EffectiveRange/pcb-mrhat/effectiveRangeHat_simple.kicad_pcb

## KiCad design effectiveRangeHat_simple.kicad_pcb (2024-08-14)

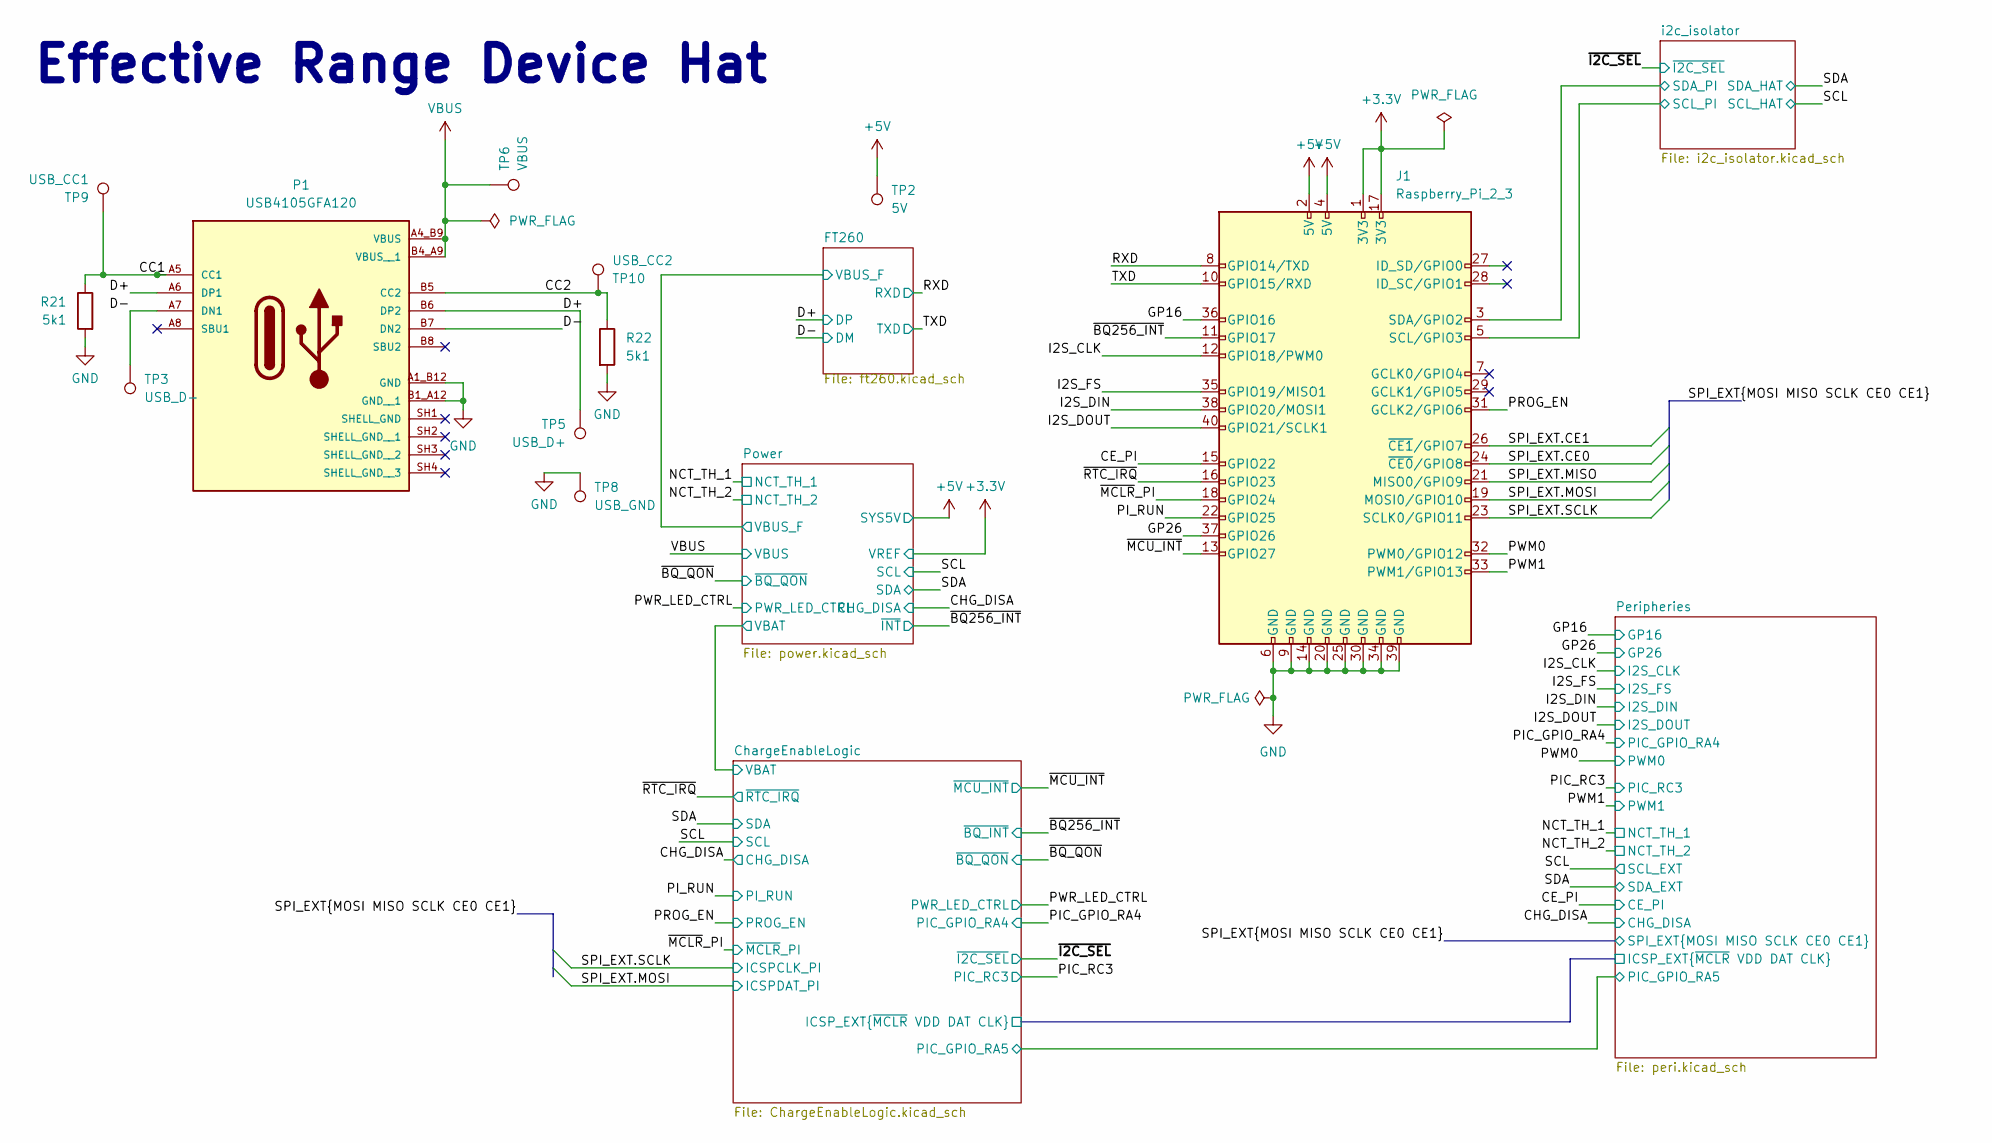
[picture p1: schematic effectiveRangeHat_simple.kicad_sch, Effective Range - MrHAT]

Parts:
J1: Raspberry_Pi_2_3; Raspberry_Pi_Zero_MountingHoles; MPN 61304021121
P1: USB4105GFA120; GCT_USB4105GFA120; PARTREV B3
R21, R22: 5k1; R_0402_1005Metric; MPN ERA-2AEB512X
TP2: 5V; TestPoint_Pad_D1.0mm
TP3: USB_D-; TestPoint_Pad_D1.0mm
TP5: USB_D+; TestPoint_Pad_D1.0mm
TP6: VBUS; TestPoint_Pad_D1.0mm
TP8: USB_GND; TestPoint_Pad_D1.0mm
TP9: USB_CC1; TestPoint_Pad_D1.0mm
TP10: USB_CC2; TestPoint_Pad_D1.0mm

Connections:
+3.3V: J1.1 (3V3), J1.17 (3V3); also elsewhere on the board
+5V: J1.2 (5V), J1.4 (5V), TP2.1; also elsewhere on the board
/CC1: P1.A5 (CC1), R21.1, TP9.1
/CC2: P1.B5 (CC2), R22.1, TP10.1
/CE_PI: J1.15 (GPIO22); also elsewhere on the board
/D+: P1.A6 (DP1), P1.B6 (DP2), TP5.1; also elsewhere on the board
/D-: P1.A7 (DN1), P1.B7 (DN2), TP3.1; also elsewhere on the board
/GP16: J1.36 (GPIO16); also elsewhere on the board
/GP26: J1.37 (GPIO26); also elsewhere on the board
/I2S_CLK: J1.12 (GPIO18/PWM0); also elsewhere on the board
/I2S_DIN: J1.38 (GPIO20/MOSI1); also elsewhere on the board
/I2S_DOUT: J1.40 (GPIO21/SCLK1); also elsewhere on the board
/I2S_FS: J1.35 (GPIO19/MISO1); also elsewhere on the board
/PI_RUN: J1.22 (GPIO25); also elsewhere on the board
/PROG_EN: J1.31 (GCLK2/GPIO6); also elsewhere on the board
/PWM0: J1.32 (PWM0/GPIO12); also elsewhere on the board
/PWM1: J1.33 (PWM1/GPIO13); also elsewhere on the board
/RXD: J1.8 (GPIO14/TXD); also elsewhere on the board
/SPI_EXT.CE0: J1.24 (~CE0/GPIO8); also elsewhere on the board
/SPI_EXT.CE1: J1.26 (~CE1/GPIO7); also elsewhere on the board
/SPI_EXT.MISO: J1.21 (MISO0/GPIO9); also elsewhere on the board
/SPI_EXT.MOSI: J1.19 (MOSI0/GPIO10); also elsewhere on the board
/SPI_EXT.SCLK: J1.23 (SCLK0/GPIO11); also elsewhere on the board
/TXD: J1.10 (GPIO15/RXD); also elsewhere on the board
/i2c_isolator/SCL_PI: J1.5 (SCL/GPIO3); also elsewhere on the board
/i2c_isolator/SDA_PI: J1.3 (SDA/GPIO2); also elsewhere on the board
/~BQ256_INT: J1.11 (GPIO17); also elsewhere on the board
/~MCLR_PI: J1.18 (GPIO24); also elsewhere on the board
/~MCU_INT: J1.13 (GPIO27); also elsewhere on the board
/~RTC_IRQ: J1.16 (GPIO23); also elsewhere on the board
GND: J1.6 (GND), J1.9 (GND), J1.14 (GND), J1.20 (GND), J1.25 (GND), J1.30 (GND), J1.34 (GND), J1.39 (GND), P1.A1_B12 (GND), P1.B1_A12 (GND__1), R21.2, R22.2, TP8.1; also elsewhere on the board
VBUS: P1.A4_B9 (VBUS), P1.B4_A9 (VBUS__1), TP6.1; also elsewhere on the board

Notes on the sheet:
Effective Range Device Hat

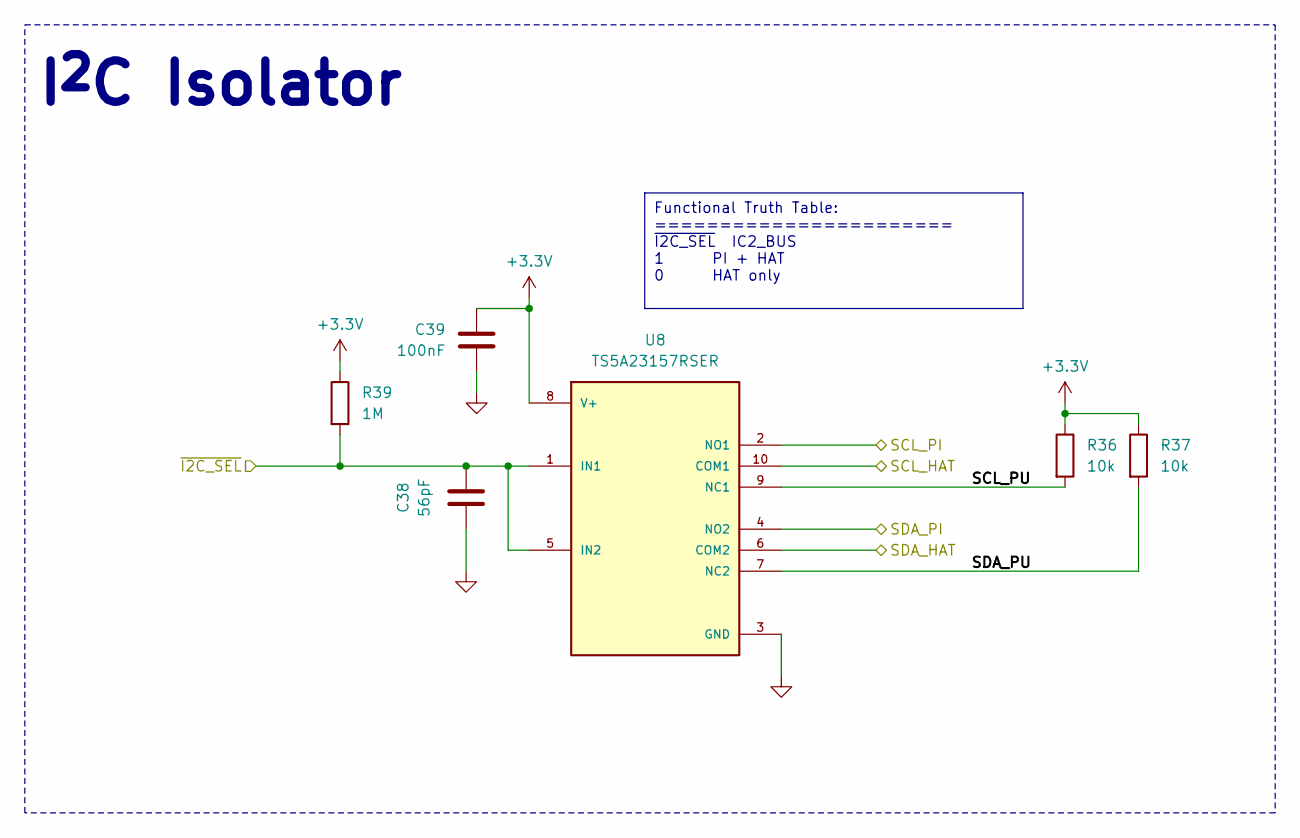
[picture p2: schematic i2c_isolator.kicad_sch, Effective Range - MrHAT]

Parts:
C38: 56pF; C_0402_1005Metric; MPN GRT1555C1H560JA02J
C39: 100nF; C_0402_1005Metric; MPN GRM155R71E104KE14J
R36, R37: 10k; R_0402_1005Metric; MPN ERJ-2GEJ103X
R39: 1M; R_0402_1005Metric; MPN ERJ-2RKF1004X
U8: TS5A23157RSER; IC_TS5A23157RSER; PARTREV 4220307/A 03/2020

Connections:
+3.3V: C39.2, R36.1, R37.1, R39.1, U8.8 (V+); also elsewhere on the board
/SCL: U8.10 (COM1); also elsewhere on the board
/SDA: U8.6 (COM2); also elsewhere on the board
/i2c_isolator/SCL_PI: U8.2 (NO1); also elsewhere on the board
/i2c_isolator/SCL_PU: R36.2, U8.9 (NC1)
/i2c_isolator/SDA_PI: U8.4 (NO2); also elsewhere on the board
/i2c_isolator/SDA_PU: R37.2, U8.7 (NC2)
/~I2C_SEL: C38.1, R39.2, U8.1 (IN1), U8.5 (IN2); also elsewhere on the board
GND: C38.2, C39.1, U8.3 (GND); also elsewhere on the board

Notes on the sheet:
Functional Truth Table: ======================= ~{I2C_SEL} IC2_BUS 1 PI + HAT 0 HAT only
I^{2}C Isolator

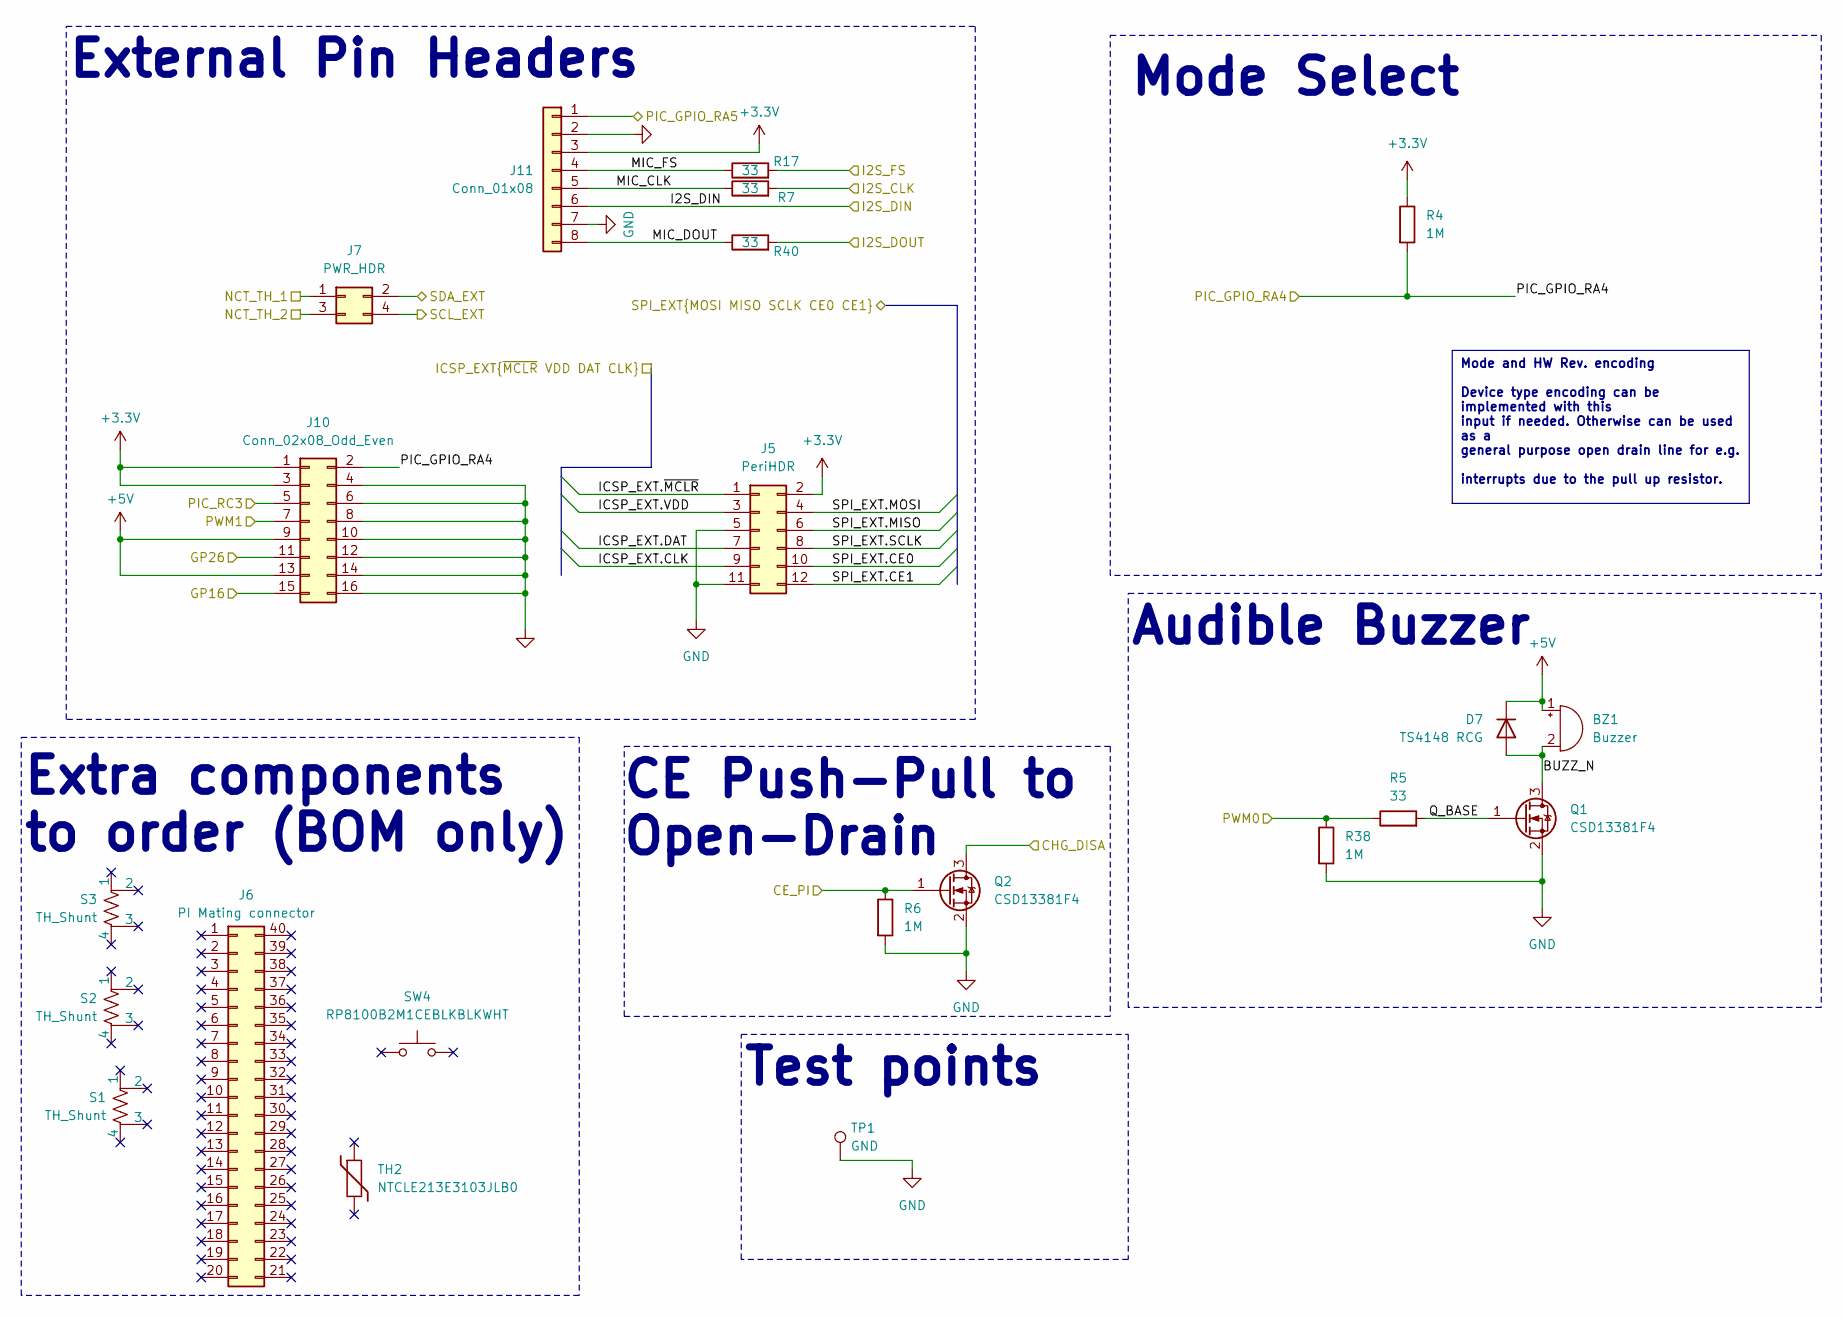
[picture p3: schematic peri.kicad_sch, Effective Range - MrHAT]

Parts:
BZ1: Buzzer; MagneticBuzzer_CUI_CMT-8504-100-SMT; MPN CMT-8504-100-SMT-TR
D7: TS4148 RCG; D_0603_1608Metric; MPN TS4148 RCG
J5: PeriHDR; PinHeader_2x06_P2.54mm_Vertical; MPN 61301221121
J6: PI Mating connector; MPN PPPC202LFBN-RC
J7: PWR_HDR; PinHeader_2x02_P2.54mm_Vertical; MPN 61300421121
J10: Conn_02x08_Odd_Even; PinHeader_2x08_P2.54mm_Vertical; MPN 61301621121
J11: Conn_01x08; PinHeader_1x08_P2.54mm_Vertical; MPN 61300811121
Q1, Q2: CSD13381F4; YJC0003A_TEX; MPN CSD13381F4
R4: 1M; R_0402_1005Metric; MPN ERJ-2RKF1004X
R5, R7, R17, R40: 33; R_0402_1005Metric; MPN ERJ-2RKF33R0X
R6, R38: 1M; R_0402_1005Metric; Tolerance 1%; MPN ERJ-2RKF1004X
S1, S2, S3: TH_Shunt; MPN QPC02SXGN-RC
SW4: RP8100B2M1CEBLKBLKWHT; MPN RP8100B2M1CEBLKBLKWHT
TH2: NTCLE213E3103JLB0; MPN NXFT15XH103FEAB035
TP1: GND; TestPoint_Pad_D1.0mm

Connections:
+3.3V: J5.2, J10.1, J10.3, J11.3, R4.1; also elsewhere on the board
+5V: BZ1.1 (+), D7.1 (K), J10.9, J10.13; also elsewhere on the board
/CE_PI: Q2.1 (G), R6.1; also elsewhere on the board
/CHG_DISA: Q2.3 (D); also elsewhere on the board
/ChargeEnableLogic/ICSP_EXT.CLK: J5.9; also elsewhere on the board
/ChargeEnableLogic/ICSP_EXT.DAT: J5.7; also elsewhere on the board
/ChargeEnableLogic/ICSP_EXT.VDD: J5.3; also elsewhere on the board
/ChargeEnableLogic/ICSP_EXT.~MCLR: J5.1; also elsewhere on the board
/ChargeEnableLogic/PIC_GPIO_RA5: J11.1; also elsewhere on the board
/GP16: J10.15; also elsewhere on the board
/GP26: J10.11; also elsewhere on the board
/I2S_CLK: R7.2; also elsewhere on the board
/I2S_DIN: J11.6; also elsewhere on the board
/I2S_DOUT: R40.2; also elsewhere on the board
/I2S_FS: R17.2; also elsewhere on the board
/NCT_TH_1: J7.1; also elsewhere on the board
/NCT_TH_2: J7.3; also elsewhere on the board
/PIC_GPIO_RA4: J10.2, R4.2; also elsewhere on the board
/PIC_RC3: J10.5; also elsewhere on the board
/PWM0: R5.1, R38.1; also elsewhere on the board
/PWM1: J10.7; also elsewhere on the board
/Peripheries/BUZZ_N: BZ1.2 (-), D7.2 (A), Q1.3 (D)
/Peripheries/MIC_CLK: J11.5, R7.1
/Peripheries/MIC_DOUT: J11.8, R40.1
/Peripheries/MIC_FS: J11.4, R17.1
/Peripheries/Q_BASE: Q1.1 (G), R5.2
/SCL: J7.4; also elsewhere on the board
/SDA: J7.2; also elsewhere on the board
/SPI_EXT.CE0: J5.10; also elsewhere on the board
/SPI_EXT.CE1: J5.12; also elsewhere on the board
/SPI_EXT.MISO: J5.6; also elsewhere on the board
/SPI_EXT.MOSI: J5.4; also elsewhere on the board
/SPI_EXT.SCLK: J5.8; also elsewhere on the board
GND: J5.5, J5.11, J10.4, J10.6, J10.8, J10.10, J10.12, J10.14, J10.16, J11.2, J11.7, Q1.2 (S), Q2.2 (S), R6.2, R38.2, TP1.1; also elsewhere on the board

Notes on the sheet:
Mode and HW Rev. encoding Device type encoding can be implemented with this input if needed. Otherwise can be used as a general purpose open drain line for e.g. interrupts due to the pull up resistor.
Mode Select
CE Push-Pull to Open-Drain
Audible Buzzer
Test points
Extra components to order (BOM only)
External Pin Headers

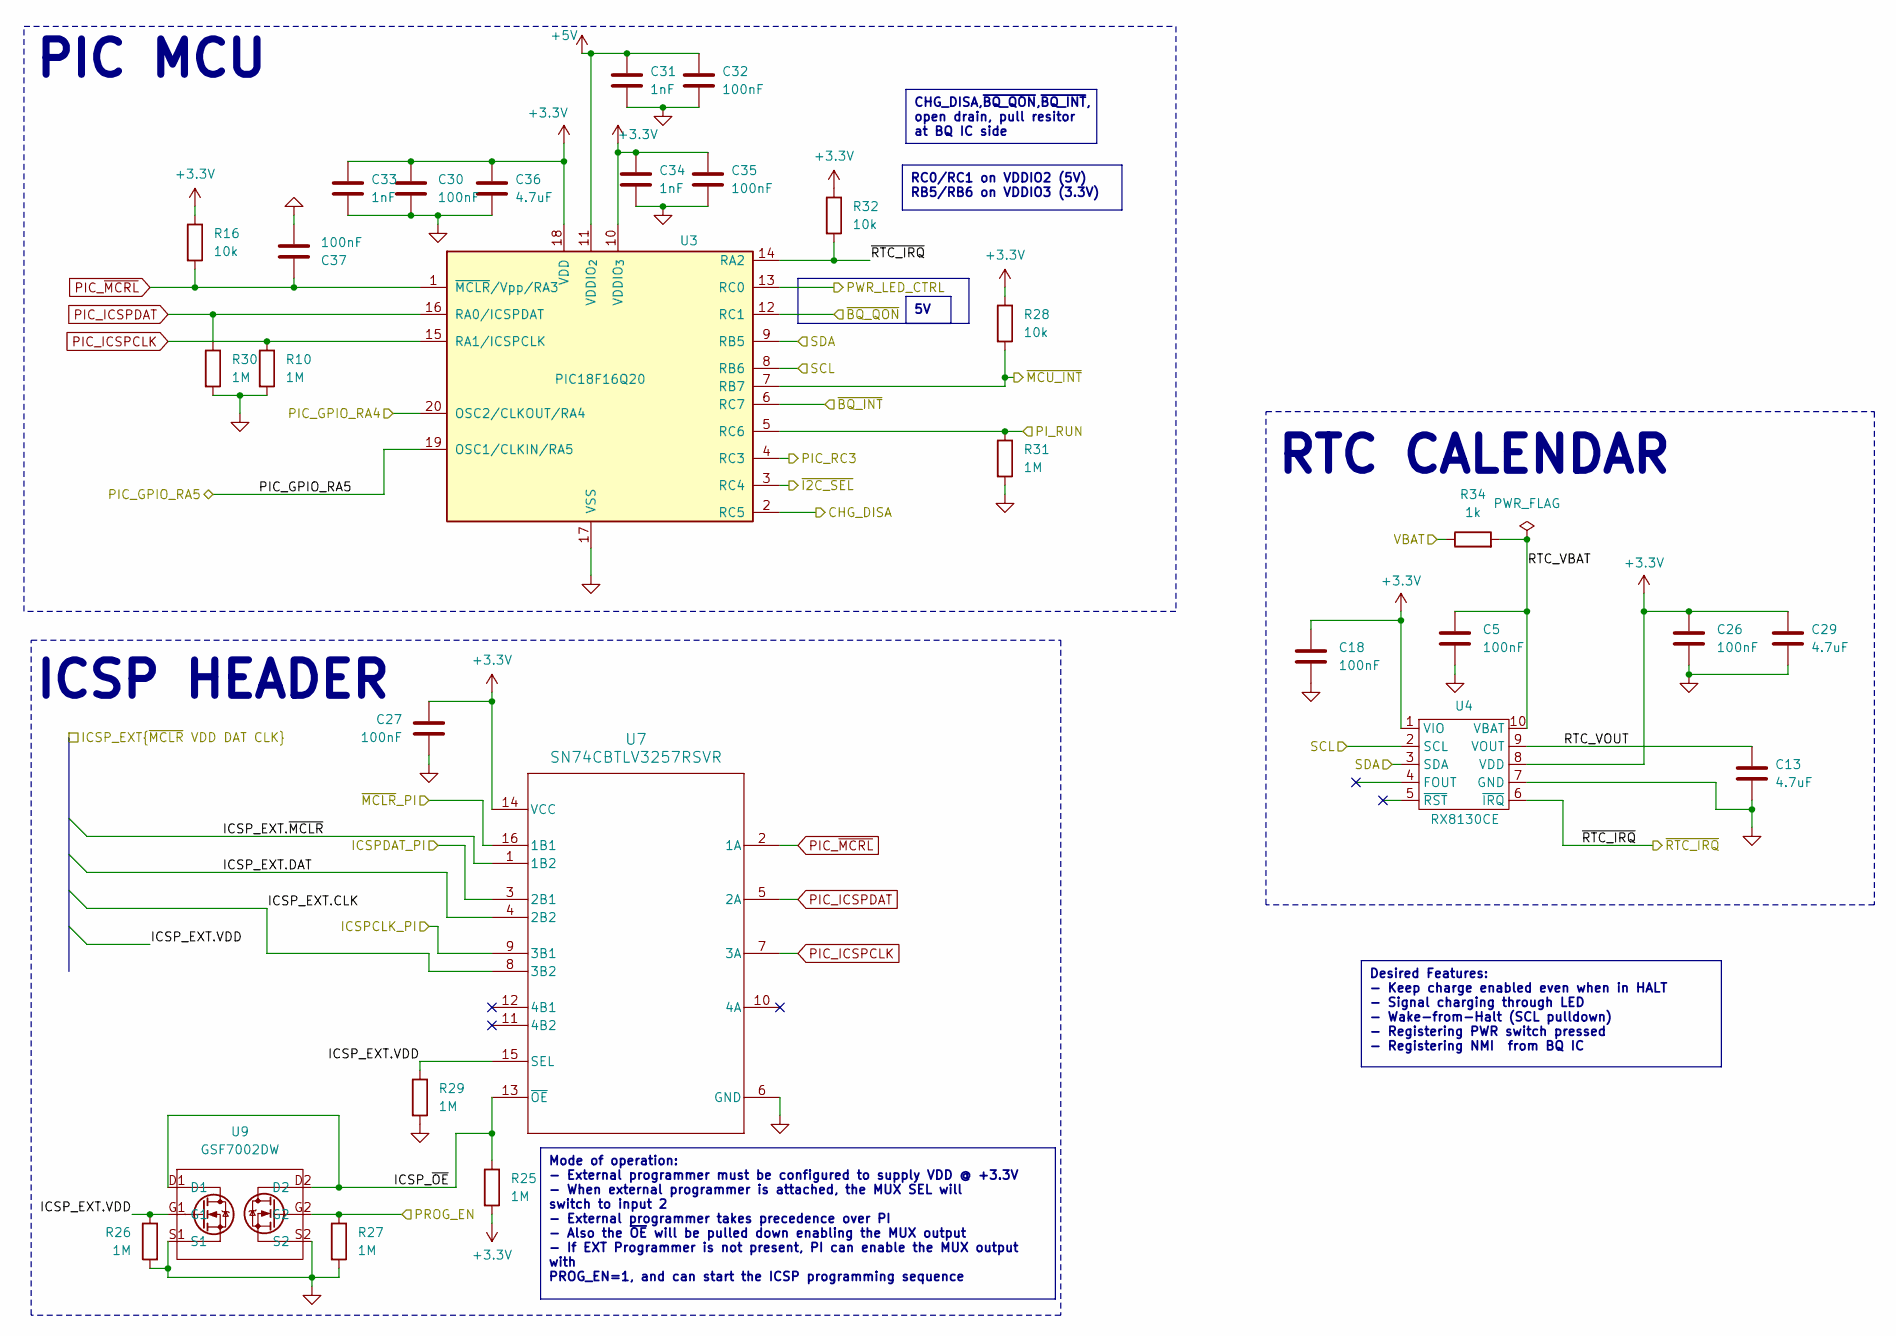
[picture p4: schematic ChargeEnableLogic.kicad_sch, Effective Range - MrHAT]

Parts:
C5, C18, C26, C27, C30, C32, C35, C37: 100nF; C_0402_1005Metric; MPN GRM155R71E104KE14J
C13, C29, C36: 4.7uF; C_0805_2012Metric; MPN GRM21BR61H475KE51L
C31, C33, C34: 1nF; C_0402_1005Metric; MPN GCM155R72A102KA37D
R10, R25, R29, R30, R31: 1M; R_0402_1005Metric; MPN ERJ-2RKF1004X
R16, R28, R32: 10k; R_0402_1005Metric; MPN ERJ-2GEJ103X
R26, R27: 1M; R_0402_1005Metric; Tolerance 1%; MPN ERJ-2RKF1004X
R34: 1k; R_0402_1005Metric; MPN ERJ-2RKF1001X
U3: PIC18F16Q20; VQFN-20-1EP_3x3mm_P0.4mm_EP1.7x1.7mm; MPN PIC18F16Q20-I/REB
U4: RX8130CE; MPN RX8130CE B0
U7: SN74CBTLV3257RSVR; RSV0016A; MPN SN74CBTLV3257RSVR
U9: GSF7002DW; MPN GSF7002DW

Connections:
+3.3V: C18.1, C26.1, C27.2, C29.1, C30.2, C33.1, C34.1, C35.1, C36.1, R16.1, R25.2, R28.1, R32.1, U3.10 (VDDIO_{3}), U3.18 (VDD), U4.1 (VIO), U4.8 (VDD), U7.14 (VCC); also elsewhere on the board
+5V: C31.1, C32.1, U3.11 (VDDIO_{2}); also elsewhere on the board
/CHG_DISA: U3.2 (RC5); also elsewhere on the board
/ChargeEnableLogic/ICSP_EXT.CLK: U7.8 (3B2); also elsewhere on the board
/ChargeEnableLogic/ICSP_EXT.DAT: U7.4 (2B2); also elsewhere on the board
/ChargeEnableLogic/ICSP_EXT.VDD: R26.1, R29.1, U7.15 (SEL), U9.G1; also elsewhere on the board
/ChargeEnableLogic/ICSP_EXT.~MCLR: U7.1 (1B2); also elsewhere on the board
/ChargeEnableLogic/ICSP_~OE: R25.1, U7.13 (~OE), U9.D1, U9.D2
/ChargeEnableLogic/PIC_GPIO_RA5: U3.19 (OSC1/CLKIN/RA5); also elsewhere on the board
/ChargeEnableLogic/RTC_VBAT: C5.1, R34.2, U4.10 (VBAT)
/ChargeEnableLogic/RTC_VOUT: C13.1, U4.9 (VOUT)
/PIC_GPIO_RA4: U3.20 (OSC2/CLKOUT/RA4); also elsewhere on the board
/PIC_RC3: U3.4 (RC3); also elsewhere on the board
/PI_RUN: R31.1, U3.5 (RC6); also elsewhere on the board
/PROG_EN: R27.1, U9.G2; also elsewhere on the board
/PWR_LED_CTRL: U3.13 (RC0); also elsewhere on the board
/Power/BAT: R34.1; also elsewhere on the board
/SCL: U3.8 (RB6), U4.2 (SCL); also elsewhere on the board
/SDA: U3.9 (RB5), U4.3 (SDA); also elsewhere on the board
/SPI_EXT.MOSI: U7.3 (2B1); also elsewhere on the board
/SPI_EXT.SCLK: U7.9 (3B1); also elsewhere on the board
/~BQ256_INT: U3.6 (RC7); also elsewhere on the board
/~BQ_QON: U3.12 (RC1); also elsewhere on the board
/~I2C_SEL: U3.3 (RC4); also elsewhere on the board
/~MCLR_PI: U7.16 (1B1); also elsewhere on the board
/~MCU_INT: R28.2, U3.7 (RB7); also elsewhere on the board
/~RTC_IRQ: R32.2, U3.14 (RA2), U4.6 (~IRQ); also elsewhere on the board
GND: C5.2, C13.2, C18.2, C26.2, C27.1, C29.2, C30.1, C31.2, C32.2, C33.2, C34.2, C35.2, C36.2, C37.1, R10.2, R26.2, R27.2, R29.2, R30.2, R31.2, U3.17 (VSS), U3.21 (VSS), U4.7 (GND), U7.6 (GND), U9.S1, U9.S2; also elsewhere on the board
PIC_ICSPCLK: R10.1, U3.15 (RA1/ICSPCLK), U7.7 (3A)
PIC_ICSPDAT: R30.1, U3.16 (RA0/ICSPDAT), U7.5 (2A)
PIC_~MCRL: C37.2, R16.2, U3.1 (~MCLR/Vpp/RA3), U7.2 (1A)

Notes on the sheet:
RC0/RC1 on VDDIO2 (5V) RB5/RB6 on VDDIO3 (3.3V)
Desired Features: - Keep charge enabled even when in HALT - Signal charging through LED - Wake-from-Halt (SCL pulldown) - Registering PWR switch pressed - Registering NMI from BQ IC
CHG_DISA,~{BQ_QON},~{BQ_INT}, open drain, pull resitor at BQ IC side
Mode of operation: - External programmer must be configured to supply VDD @ +3.3V - When external programmer is attached, the MUX SEL will switch to input 2 - External programmer takes precedence over PI - Also the ~{OE} will be pulled down enabling the MUX output - If EXT Programmer is not present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
RTC CALENDAR
ICSP HEADER
PIC MCU

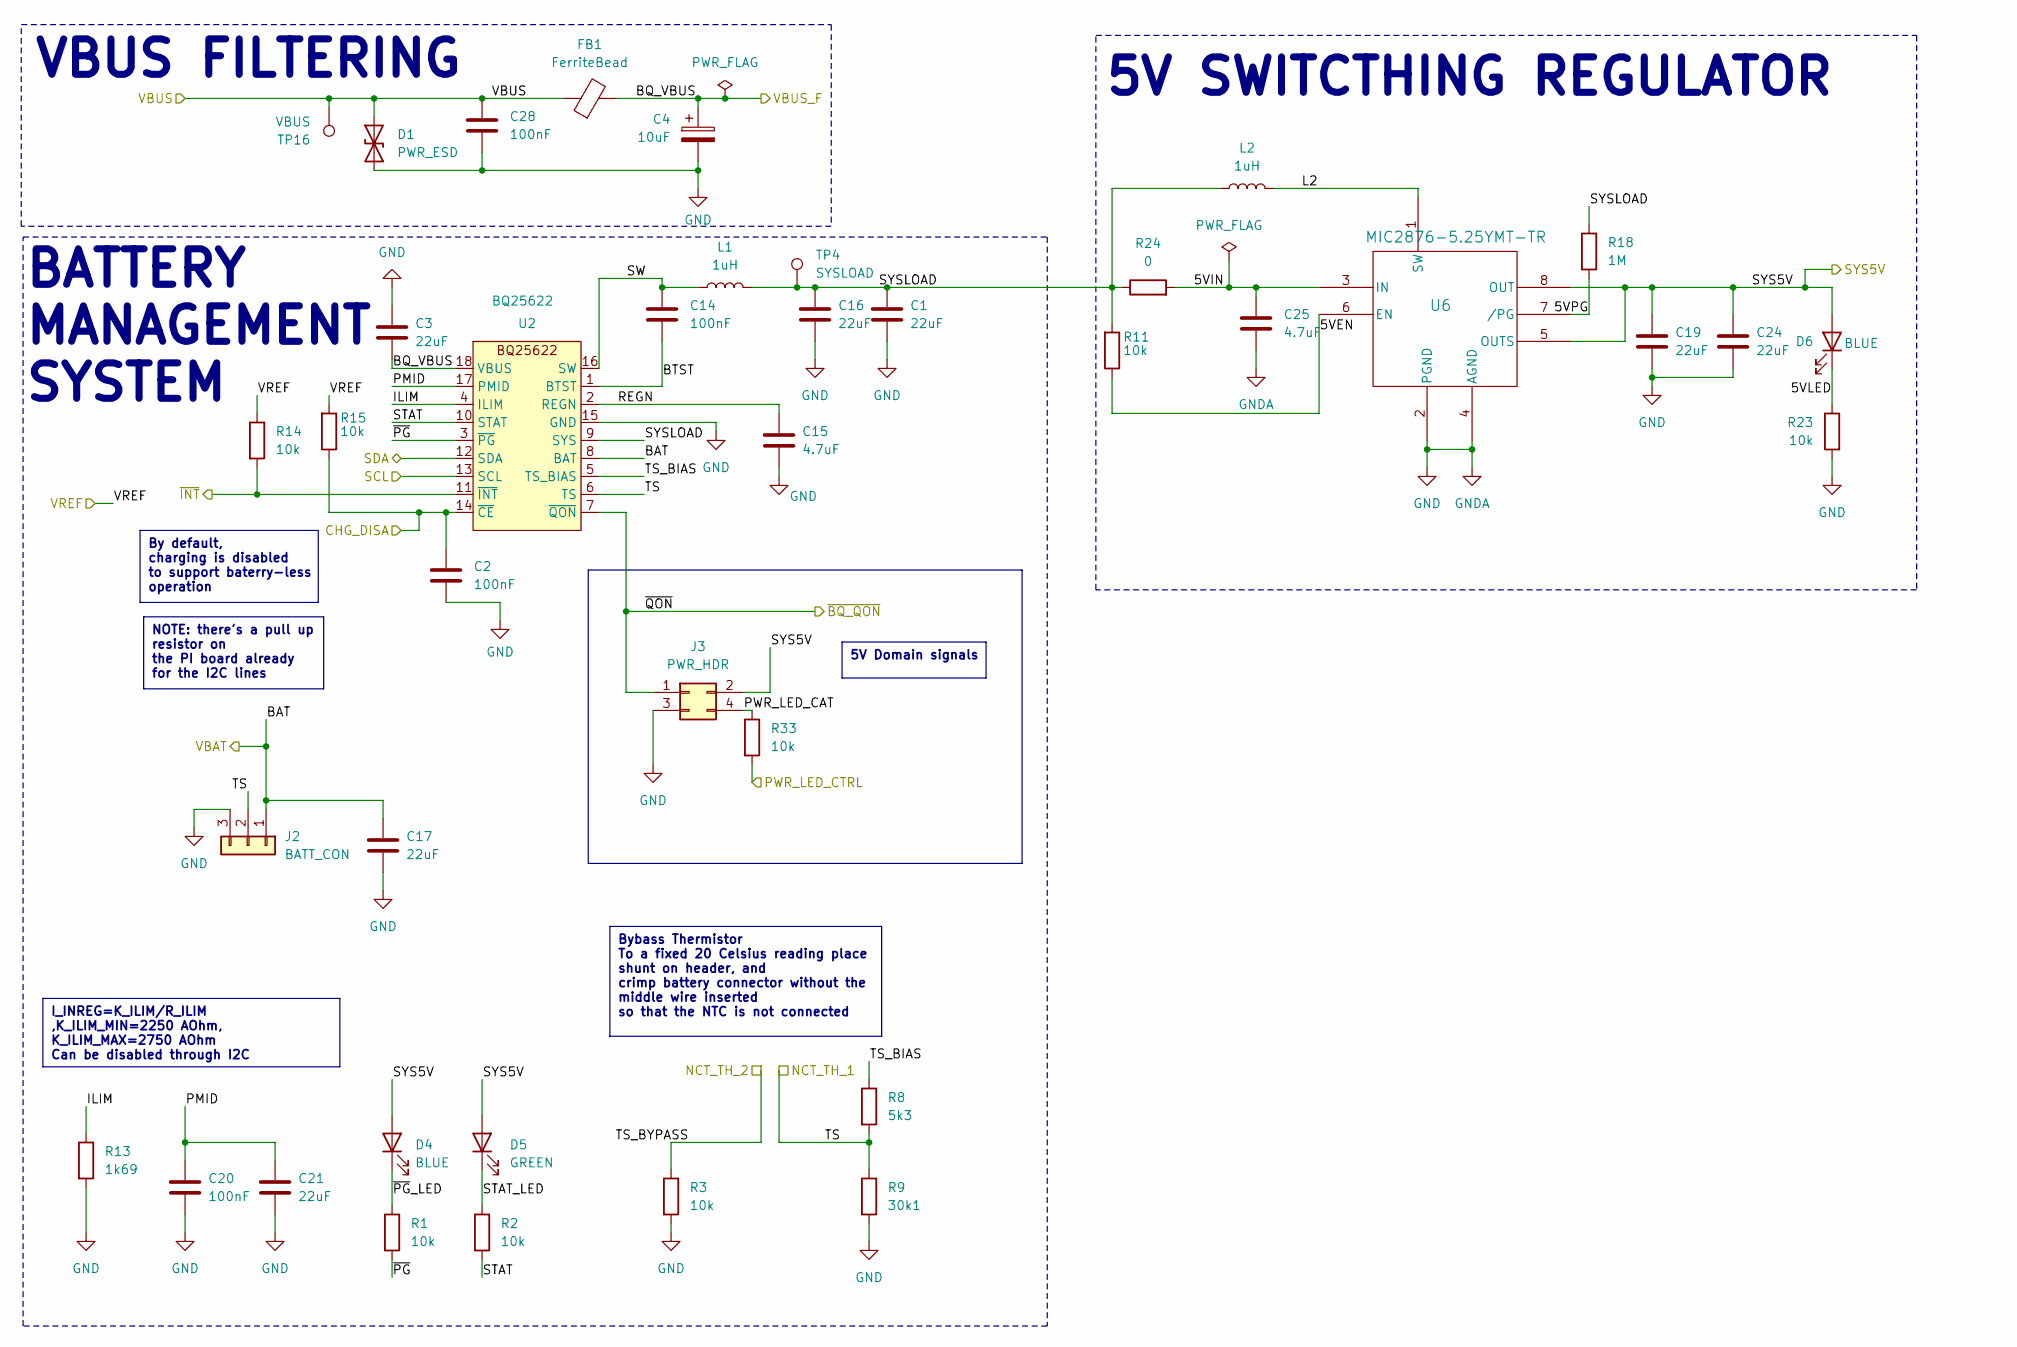
[picture p5: schematic power.kicad_sch, Effective Range - MrHAT]

Parts:
C1, C3, C16, C17, C19, C21, C24: 22uF; C_0805_2012Metric; MPN GRM21BR61E226ME44K
C2, C14, C20, C28: 100nF; C_0402_1005Metric; MPN GRM155R71E104KE14J
C4: 10uF; CAP_EEHZC1J100P; MPN EEH-ZC1J100P
C15, C25: 4.7uF; C_0805_2012Metric; MPN GRM21BR61H475KE51L
D1: PWR_ESD; D_0603_1608Metric; MPN PESD0603-240
D4, D6: BLUE; LED_0603; MPN 150060BS75000
D5: GREEN; LED_0603; MPN 150060GS75000
FB1: FerriteBead; L_1210_3225Metric; MPN BLE32PN260SH1L
J2: BATT_CON; JST_XH_B3B-XH-A_1x03_P2.50mm_Vertical; MPN B3B-XH-A
J3: PWR_HDR; PinHeader_2x02_P2.54mm_Vertical; MPN 61300421121
L1, L2: 1uH; L_1210_3225Metric; MPN DFE322520FD-1R0M=P2
R1, R2, R3, R11, R14, R15, R23, R33: 10k; R_0402_1005Metric; MPN ERJ-2GEJ103X
R8: 5k3; R_0402_1005Metric; MPN RT0402DRE075K3L
R9: 30k1; R_0402_1005Metric; MPN ERA-2AEB3012X
R13: 1k69; R_0402_1005Metric; MPN ERJ-2RKF1691X
R18: 1M; R_0402_1005Metric; Tolerance 1%; MPN ERJ-2RKF1004X
R24: 0; R_0603_1608Metric; Tolerance 1%; MPN ERJ-3GEY0R00V
TP4: SYSLOAD; TestPoint_Pad_D1.0mm
TP16: VBUS; TestPoint_Pad_D1.0mm
U2: BQ25622; MPN BQ25622RYKR
U6: MIC2876-5.25YMT-TR; TDFN22-8LD-PL-1_MCH; MPN MIC2876-5.25YMT-TR

Connections:
+3.3V: R14.1, R15.2; also elsewhere on the board
+5V: C19.1, C24.1, D4.2 (A), D5.2 (A), D6.2 (A), J3.2, U6.5 (OUTS), U6.8 (OUT); also elsewhere on the board
/CHG_DISA: C2.1, R15.1, U2.14 (~CE); also elsewhere on the board
/FT260/VCCIN: C3.2, C4.1, FB1.2, U2.18 (VBUS); also elsewhere on the board
/NCT_TH_1: J2.2, R8.2, R9.1, U2.6 (TS); also elsewhere on the board
/NCT_TH_2: R3.1; also elsewhere on the board
/PWR_LED_CTRL: R33.2; also elsewhere on the board
/Power/5VEN: R11.1, U6.6 (EN)
/Power/5VIN: C25.1, R24.2, U6.3 (IN)
/Power/5VLED: D6.1 (K), R23.1
/Power/5VPG: R18.2, U6.7 (/PG)
/Power/BAT: C17.1, J2.1, U2.8 (BAT); also elsewhere on the board
/Power/BTST: C14.2, U2.1 (BTST)
/Power/ILIM: R13.1, U2.4 (ILIM)
/Power/L2: L2.2, U6.1 (SW)
/Power/PMID: C20.1, C21.1, U2.17 (PMID)
/Power/PWR_LED_CAT: J3.4, R33.1
/Power/REGN: C15.1, U2.2 (REGN)
/Power/STAT: R2.2, U2.10 (STAT)
/Power/STAT_LED: D5.1 (K), R2.1
/Power/SW: C14.1, L1.1, U2.16 (SW)
/Power/SYSLOAD: C1.1, C16.1, L1.2, L2.1, R11.2, R18.1, R24.1, TP4.1, U2.9 (SYS)
/Power/TS_BIAS: R8.1, U2.5 (TS_BIAS)
/Power/~PG: R1.2, U2.3 (~PG)
/Power/~PG_LED: D4.1 (K), R1.1
/SCL: U2.13 (SCL); also elsewhere on the board
/SDA: U2.12 (SDA); also elsewhere on the board
/~BQ256_INT: R14.2, U2.11 (~INT); also elsewhere on the board
/~BQ_QON: J3.1, U2.7 (~QON); also elsewhere on the board
GND: C1.2, C2.2, C3.1, C4.2, C15.2, C16.2, C17.2, C19.2, C20.2, C21.2, C24.2, C25.2, C28.2, D1.1 (A1), J2.3, J3.3, R3.2, R9.2, R13.2, R23.2, U2.15 (GND), U6.2 (PGND), U6.4 (AGND), U6.9 (AGND); also elsewhere on the board
VBUS: C28.1, D1.2 (A2), FB1.1, TP16.1; also elsewhere on the board

Notes on the sheet:
NOTE: there's a pull up resistor on the PI board already for the I2C lines
Bybass Thermistor To a fixed 20 Celsius reading place shunt on header, and crimp battery connector without the middle wire inserted so that the NTC is not connected
I_INREG=K_ILIM/R_ILIM ,K_ILIM_MIN=2250 AOhm, K_ILIM_MAX=2750 AOhm Can be disabled through I2C
5V Domain signals
By default, charging is disabled to support baterry-less operation
5V SWITCTHING REGULATOR
BATTERY MANAGEMENT SYSTEM
VBUS FILTERING

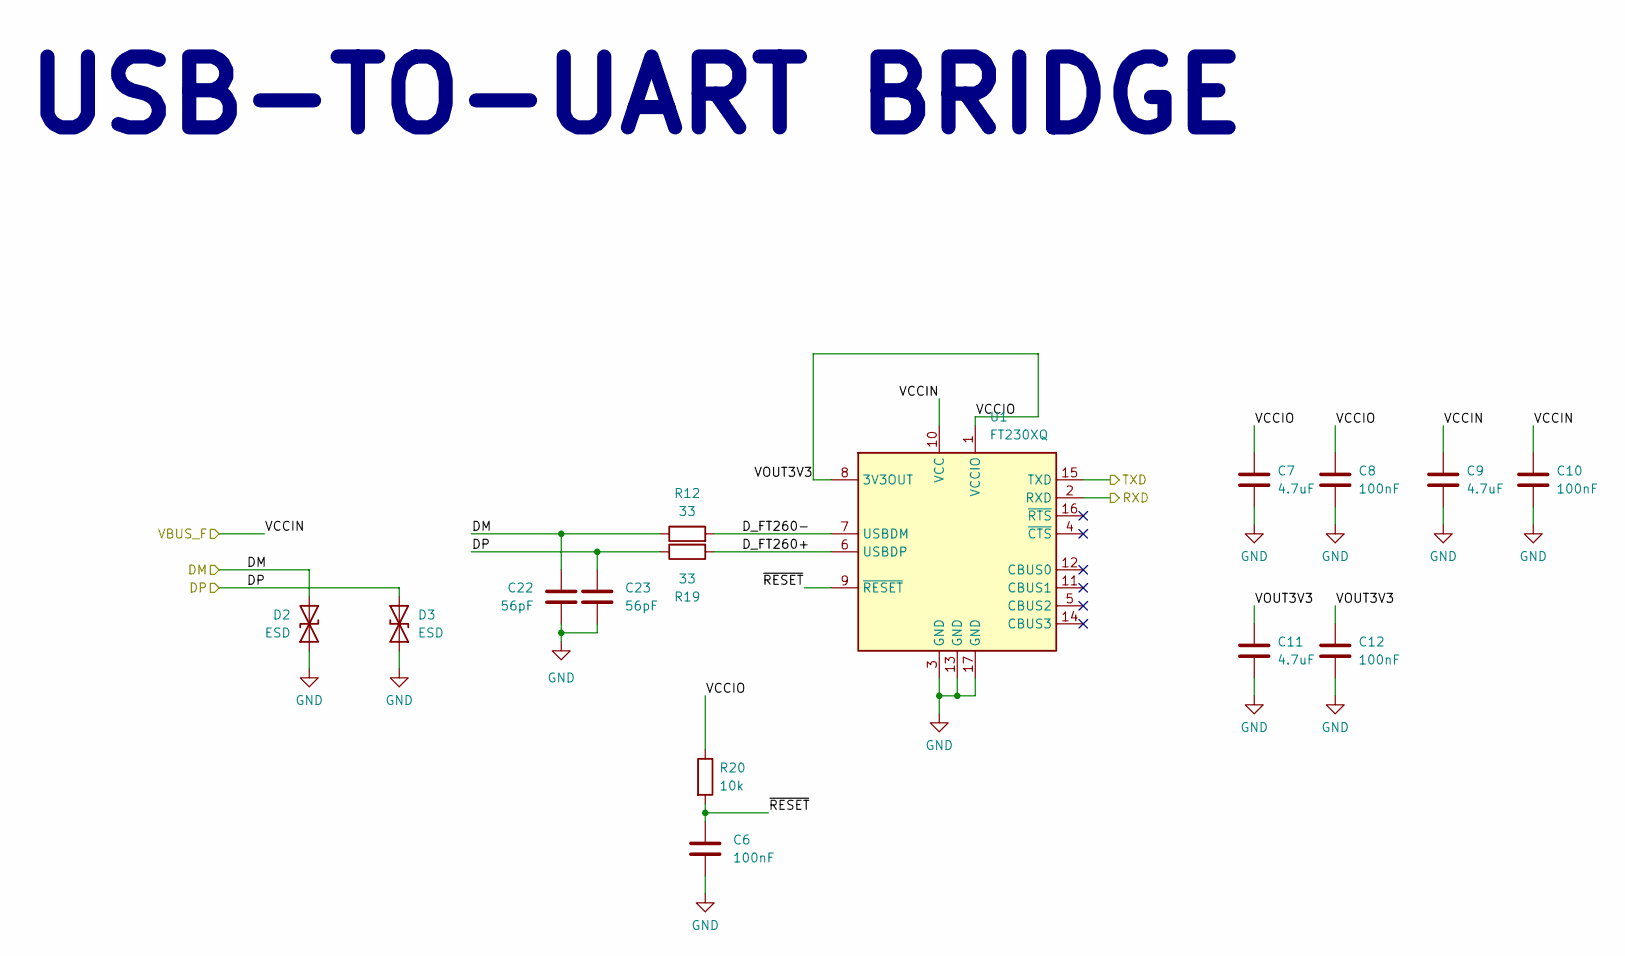
[picture p6: schematic ft260.kicad_sch, Effective Range - MrHAT]

Parts:
C6, C8, C10, C12: 100nF; C_0402_1005Metric; MPN GRM155R71E104KE14J
C7, C9, C11: 4.7uF; C_0805_2012Metric; MPN GRM21BR61H475KE51L
C22, C23: 56pF; C_0402_1005Metric; MPN GRT1555C1H560JA02J
D2, D3: ESD; D_0402_1005Metric; MPN ESDUD05BFX
R12, R19: 33; R_0402_1005Metric; MPN ERJ-2RKF33R0X
R20: 10k; R_0402_1005Metric; MPN ERJ-2GEJ103X
U1: FT230XQ; QFN-16-1EP_4x4mm_P0.65mm_EP2.1x2.1mm_4ThermalVias; MPN FT230XQ-T

Connections:
/D+: C23.1, D3.2 (A2), R19.1; also elsewhere on the board
/D-: C22.1, D2.2 (A2), R12.1; also elsewhere on the board
/FT260/D_FT260+: R19.2, U1.6 (USBDP)
/FT260/D_FT260-: R12.2, U1.7 (USBDM)
/FT260/VCCIN: C9.1, C10.1, U1.10 (VCC); also elsewhere on the board
/FT260/VCCIO: C7.1, C8.1, C11.1, C12.1, R20.1, U1.1 (VCCIO), U1.8 (3V3OUT)
/FT260/~RESET: C6.1, R20.2, U1.9 (~RESET)
/RXD: U1.2 (RXD); also elsewhere on the board
/TXD: U1.15 (TXD); also elsewhere on the board
GND: C6.2, C7.2, C8.2, C9.2, C10.2, C11.2, C12.2, C22.2, C23.2, D2.1 (A1), D3.1 (A1), U1.3 (GND), U1.13 (GND), U1.17 (GND); also elsewhere on the board

Notes on the sheet:
USB-TO-UART BRIDGE

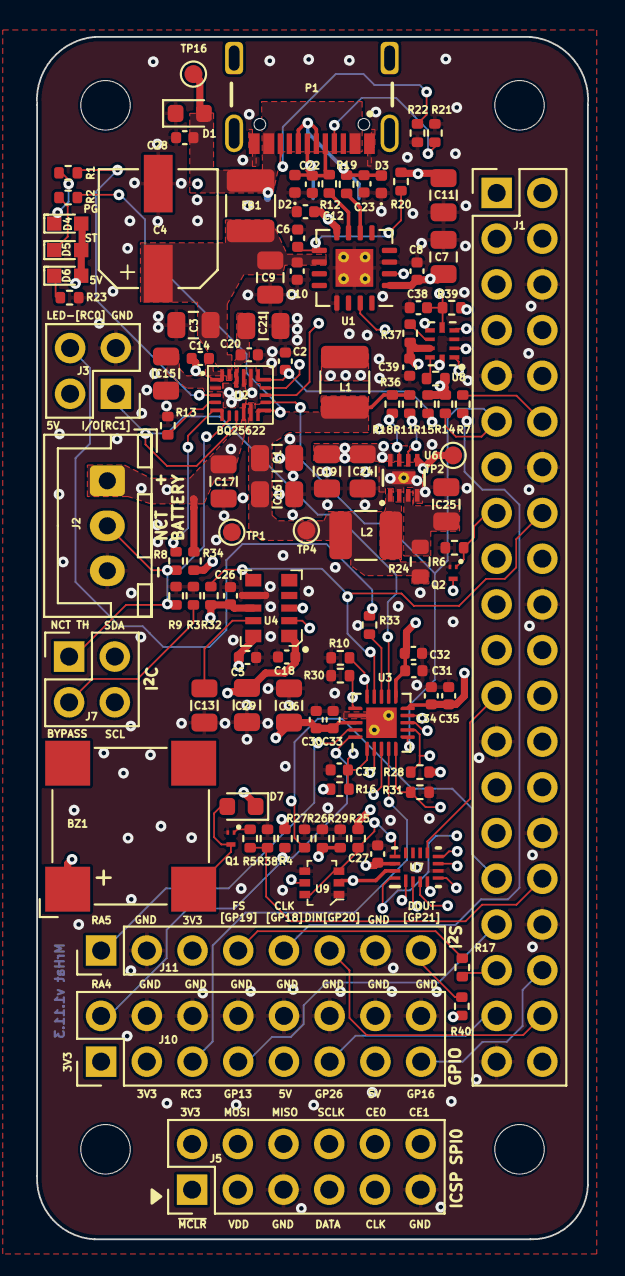
[picture p7: board effectiveRangeHat_simple.kicad_pcb from above]

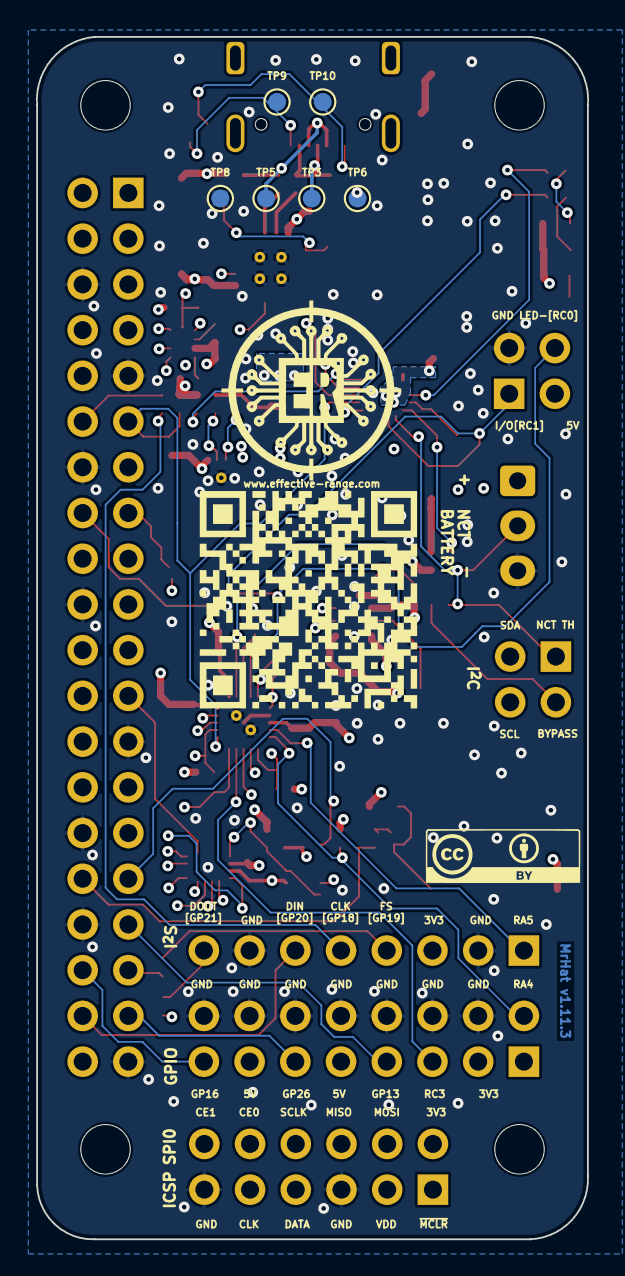
[picture p8: board effectiveRangeHat_simple.kicad_pcb from below]

Board: 8 copper layers, 30.6 x 66.8 mm, 117 parts (6 on the bottom side), 83 nets.
