EffectiveRange/pcb-mrhat/(commit log)

2024-06-17 Bumping release from 1.9.0 to 1.10.0
    [ChargeEnableLogic.kicad_sch, effectiveRangeHat_simple.kicad_pcb, effectiveRangeHat_simple.kicad_sch, ft260.kicad_sch, i2c_isolator.kicad_sch, peri.kicad_sch, power.kicad_sch]
2024-06-17 fix position
    [effectiveRangeHat_simple.kicad_pcb]
2024-06-17 Bumping release from 1.10.0 to 1.10.1
    [ChargeEnableLogic.kicad_sch, effectiveRangeHat_simple.kicad_pcb, effectiveRangeHat_simple.kicad_sch, ft260.kicad_sch, i2c_isolator.kicad_sch, peri.kicad_sch, power.kicad_sch]
2024-07-20 fix: modifications after driver completion
    - Added missing RTC IRQ to PI
    - RTC VBAT is not connected to the Main Battery trough a ~1k resistor
    - Connected BQ CE through a Push-pull to Open-Drain converter to PI
    - Changed Mosfets to TI PicoStar model
    [ChargeEnableLogic.kicad_sch, effectiveRangeHat_simple.kicad_pcb, effectiveRangeHat_simple.kicad_sch, peri.kicad_sch, power.kicad_sch]
2024-07-20 fix: erc errors
    [ChargeEnableLogic.kicad_sch, effectiveRangeHat_simple.kicad_pcb, effectiveRangeHat_simple.kicad_sch]
2024-07-24 fix: pcb changes, moved i2c ext header to 2x2 pin at the edge, pinout adjustments, silkscreen fixes
    [ChargeEnableLogic.kicad_sch, effectiveRangeHat_simple.kicad_pcb, effectiveRangeHat_simple.kicad_sch, peri.kicad_sch, power.kicad_sch]
2024-07-24 Bumping release from 1.10.1 to 1.11.0
    [ChargeEnableLogic.kicad_sch, effectiveRangeHat_simple.kicad_pcb, effectiveRangeHat_simple.kicad_sch, ft260.kicad_sch, i2c_isolator.kicad_sch, peri.kicad_sch, power.kicad_sch]
2024-08-14 fix: NTC resistor values
    [power.kicad_sch]
2024-08-14 Bumping release from 1.11.0 to 1.11.1
    [ChargeEnableLogic.kicad_sch, effectiveRangeHat_simple.kicad_pcb, effectiveRangeHat_simple.kicad_sch, ft260.kicad_sch, i2c_isolator.kicad_sch, peri.kicad_sch, power.kicad_sch]
2024-08-14 Bumping release from 1.11.1 to 1.11.2
    [ChargeEnableLogic.kicad_sch, effectiveRangeHat_simple.kicad_pcb, effectiveRangeHat_simple.kicad_sch, ft260.kicad_sch, i2c_isolator.kicad_sch, peri.kicad_sch, power.kicad_sch]
2024-08-14 fix: drc error
    [effectiveRangeHat_simple.kicad_pcb]
2024-08-14 Bumping release from 1.11.2 to 1.11.3
    [ChargeEnableLogic.kicad_sch, effectiveRangeHat_simple.kicad_pcb, effectiveRangeHat_simple.kicad_sch, ft260.kicad_sch, i2c_isolator.kicad_sch, peri.kicad_sch, power.kicad_sch]
2024-09-17 feat: 3V3 regulator + complete rework to 16 layers
    [ChargeEnableLogic.kicad_sch, effectiveRangeHat_simple.kicad_sch, ft260.kicad_sch, i2c_isolator.kicad_sch, peri.kicad_sch, power.kicad_sch]
2024-09-17 Bumping release from 1.11.3 to 1.12.0
    [ChargeEnableLogic.kicad_sch, effectiveRangeHat_simple.kicad_sch, ft260.kicad_sch, i2c_isolator.kicad_sch, peri.kicad_sch, power.kicad_sch]
2024-10-30 1.13 rework
    - routing adjustments and rework
    - fix tps22995 footprint
    - fix tps22995 capacitor
    - silkscreen adjustments
    - replaced VIN capacitor to ceramic
    - added external VIN headers
    [effectiveRangeHat_simple.kicad_sch, peri.kicad_sch, power.kicad_sch]
2024-10-30 Bumping release from 1.12.0 to 1.13.0
    [ChargeEnableLogic.kicad_sch, effectiveRangeHat_simple.kicad_sch, ft260.kicad_sch, i2c_isolator.kicad_sch, peri.kicad_sch, power.kicad_sch]
2025-02-14 v1.14 mods
    [ChargeEnableLogic.kicad_sch, effectiveRangeHat_simple.kicad_sch, ft260.kicad_sch, i2c_isolator.kicad_sch, peri.kicad_sch, power.kicad_sch]
2025-03-02 connector reorg, trace adjustments
    [effectiveRangeHat_simple.kicad_sch, peri.kicad_sch, power.kicad_sch]
2025-03-02 trace adjs
2025-03-02 minor trace adjustments
2025-03-02 Bumping release from 1.13.0 to 1.14.0
    [ChargeEnableLogic.kicad_sch, effectiveRangeHat_simple.kicad_sch, ft260.kicad_sch, i2c_isolator.kicad_sch, peri.kicad_sch, power.kicad_sch]
2025-03-03 Bumping release from 1.14.0 to 1.14.1
    [ChargeEnableLogic.kicad_sch, effectiveRangeHat_simple.kicad_sch, ft260.kicad_sch, i2c_isolator.kicad_sch, peri.kicad_sch, power.kicad_sch]
