EffectiveRange/pcb-mrhat/(notices)

Notices in the files:
effectiveRangeHat_simple.kicad_sch:
visit https://creativecommons.org/licenses/by/4.0
is licensed under CC BY 4.0. To view a copy of this license,
License: MrHAT © 2024 by Ferenc Nandor Janky & Attila Gombos
